vehar/SMPS-Noise-Filter/datasheets/Omron S8FS - Sample Photo.jpg

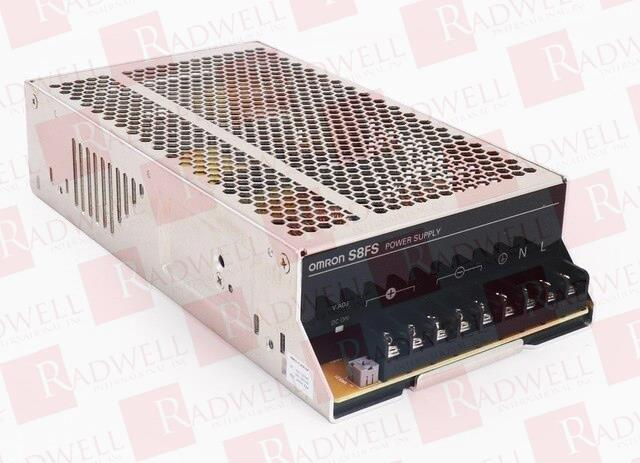
datasheets/Omron S8FS - Sample Photo.jpg
