vehar/SMPS-Noise-Filter/datasheets/Omron-S8FS-C05012-30132897-01.jpg

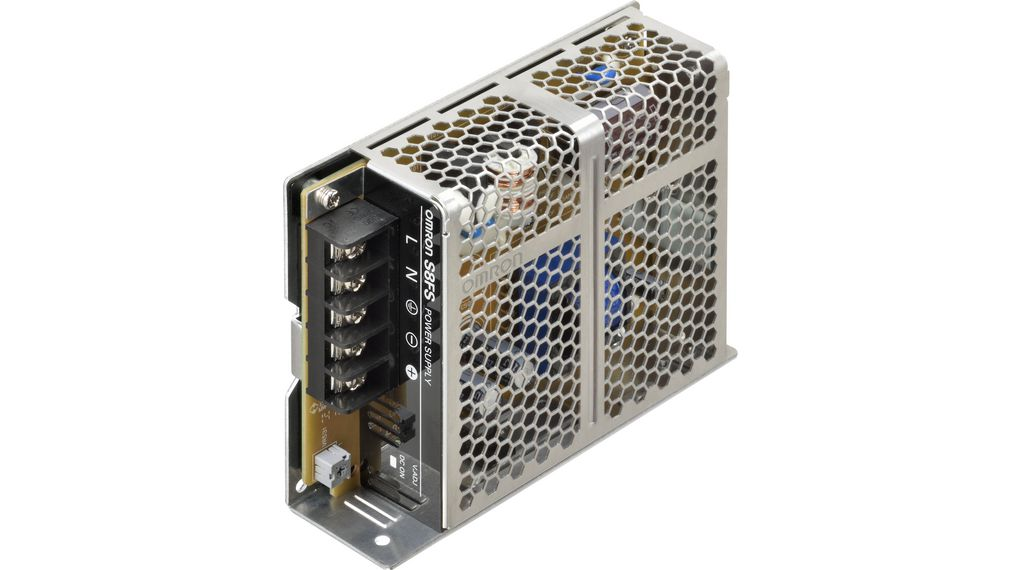
datasheets/Omron-S8FS-C05012-30132897-01.jpg
