vehar/SMPS-Noise-Filter/images/[Commercial CMC] Wurth-S14100038-Mouse-20A-Only.jpg

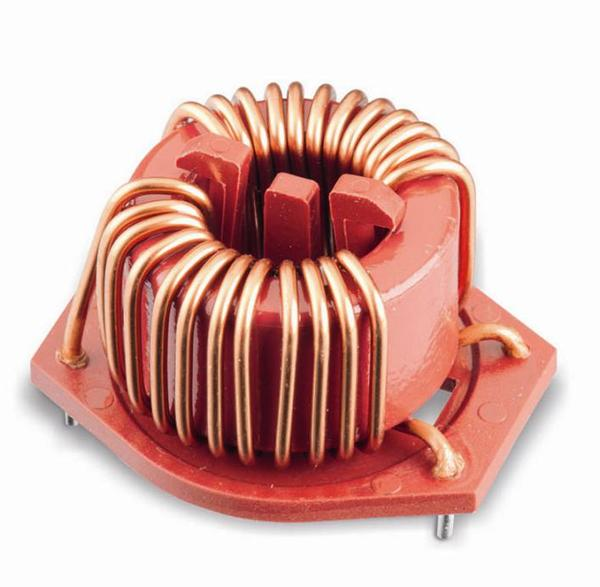
images/[Commercial CMC] Wurth-S14100038-Mouse-20A-Only.jpg
