vehar/SMPS-Noise-Filter/images/[eBay] Power supply filter board 4A EMI filter.jpg

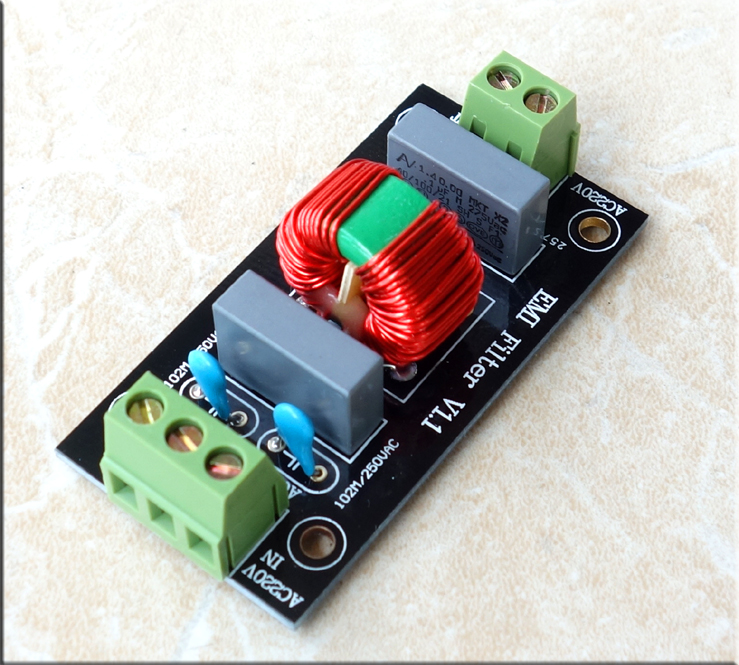
images/[eBay] Power supply filter board 4A EMI filter.jpg
