vehar/SMPS-Noise-Filter/images/B8272xE6_series_DSL.webp

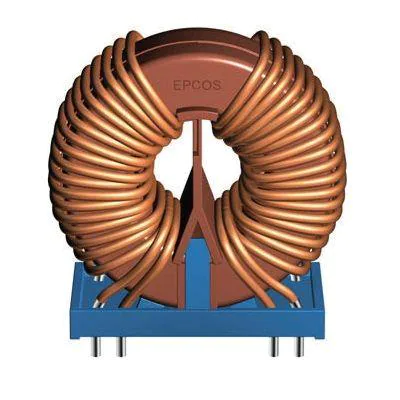
images/B8272xE6_series_DSL.webp
