vehar/SMPS-Noise-Filter/images/cmc_wide.png

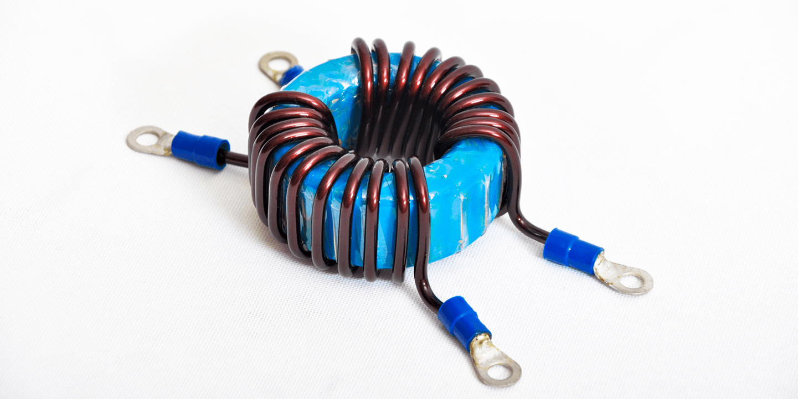
images/cmc_wide.png
