vehar/SMPS-Noise-Filter/images/EPCOS - TDK B8272xV2xUx Ring Core Double Chokes.webp

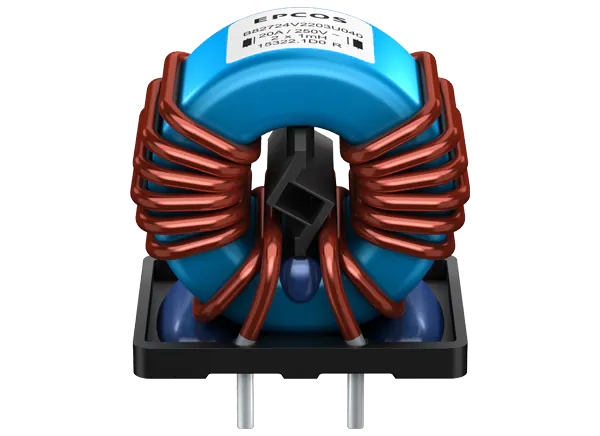
images/EPCOS - TDK B8272xV2xUx Ring Core Double Chokes.webp
