vehar/SMPS-Noise-Filter/images/Megas3300 - 1.jpeg

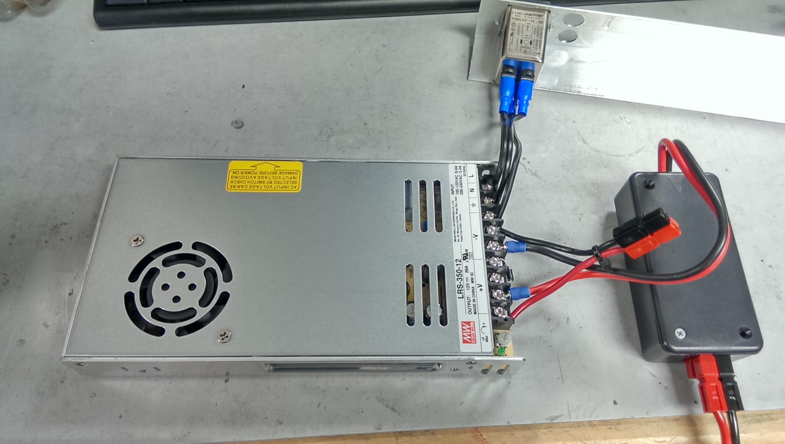
images/Megas3300 - 1.jpeg
