vehar/SMPS-Noise-Filter/images/Megas3300 - 2.jpeg

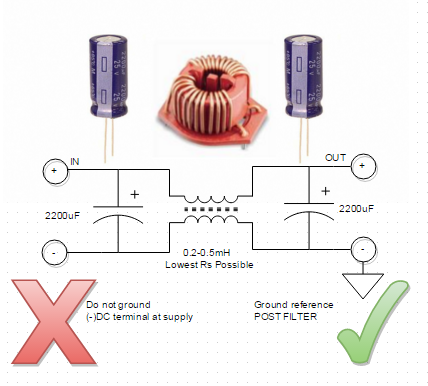
images/Megas3300 - 2.jpeg
