vehar/SMPS-Noise-Filter/images/Screenshot_2021-09-07_18-41-37.png

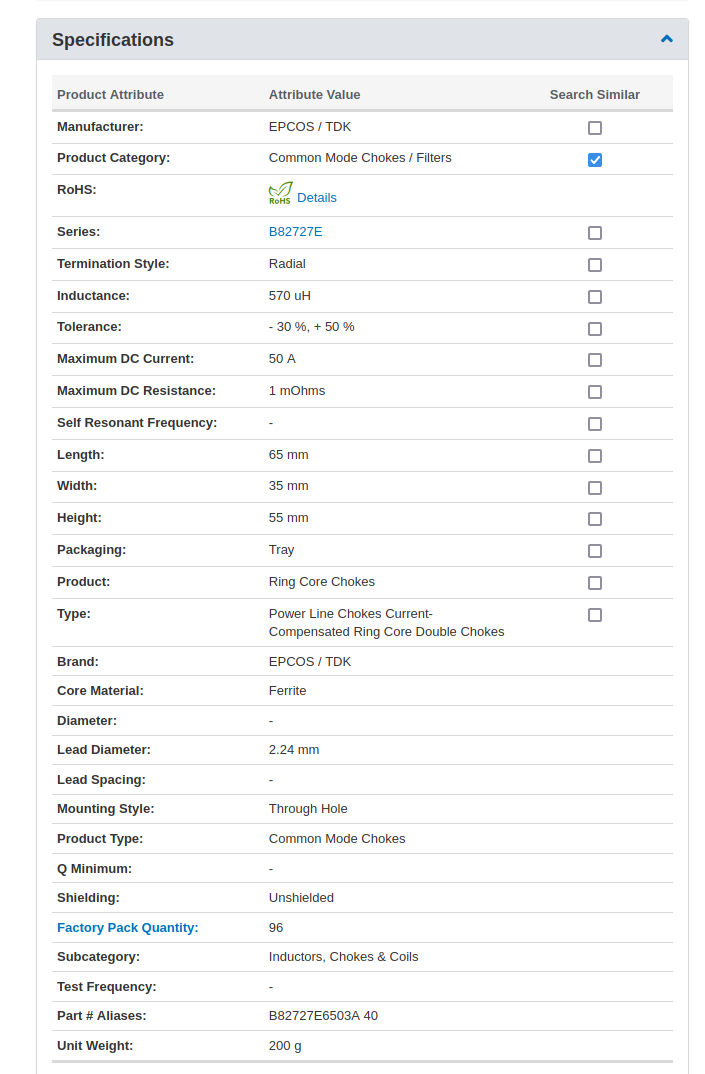
images/Screenshot_2021-09-07_18-41-37.png
