vehar/SMPS-Noise-Filter/images/Screenshot_2021-09-08_13-42-32.png

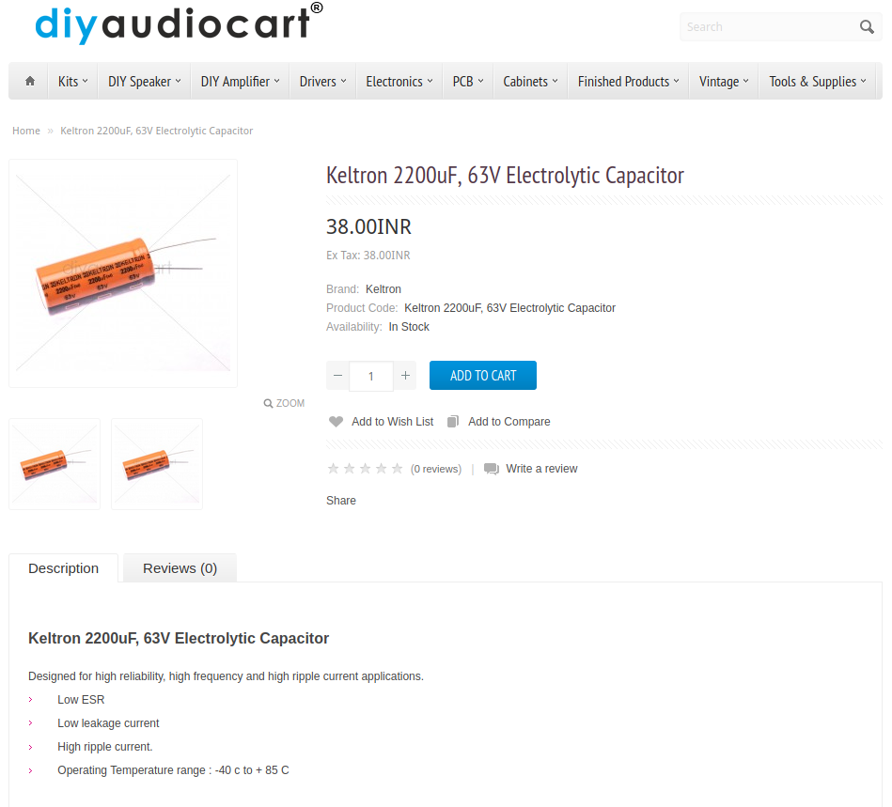
images/Screenshot_2021-09-08_13-42-32.png
