vehar/SMPS-Noise-Filter/images/Wurth 2.2MH 5A CMC.webp

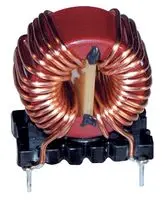
images/Wurth 2.2MH 5A CMC.webp
