vehar/SMPS-Noise-Filter/references/elcom-emi-filter.jpg

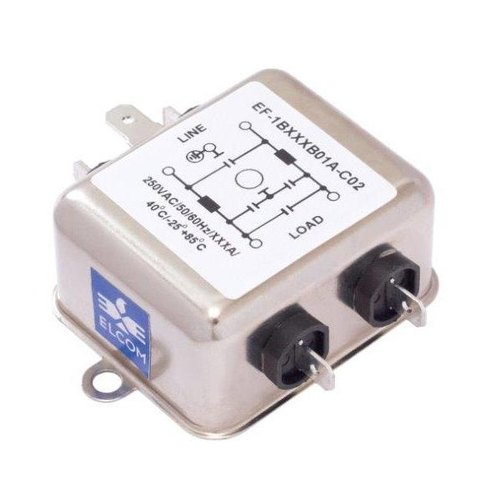
references/elcom-emi-filter.jpg
