vehar/SMPS-Noise-Filter/references/rfi-emi-ac-single-phase-panel-type-mounting-filter-500x500.jpg

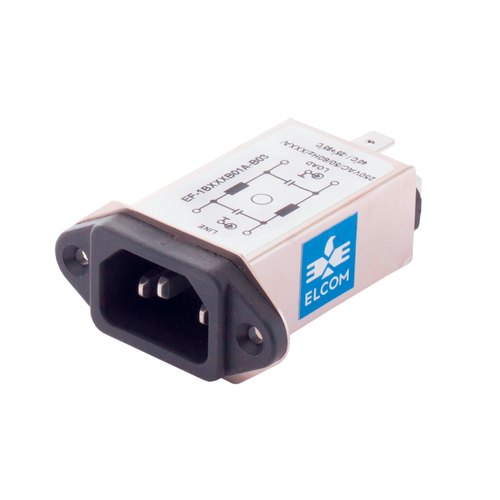
references/rfi-emi-ac-single-phase-panel-type-mounting-filter-500x500.jpg
