vehar/SMPS-Noise-Filter/simulations/Buck Ripple + Noise - Screenshot_2021-02-02_11-28-45.png

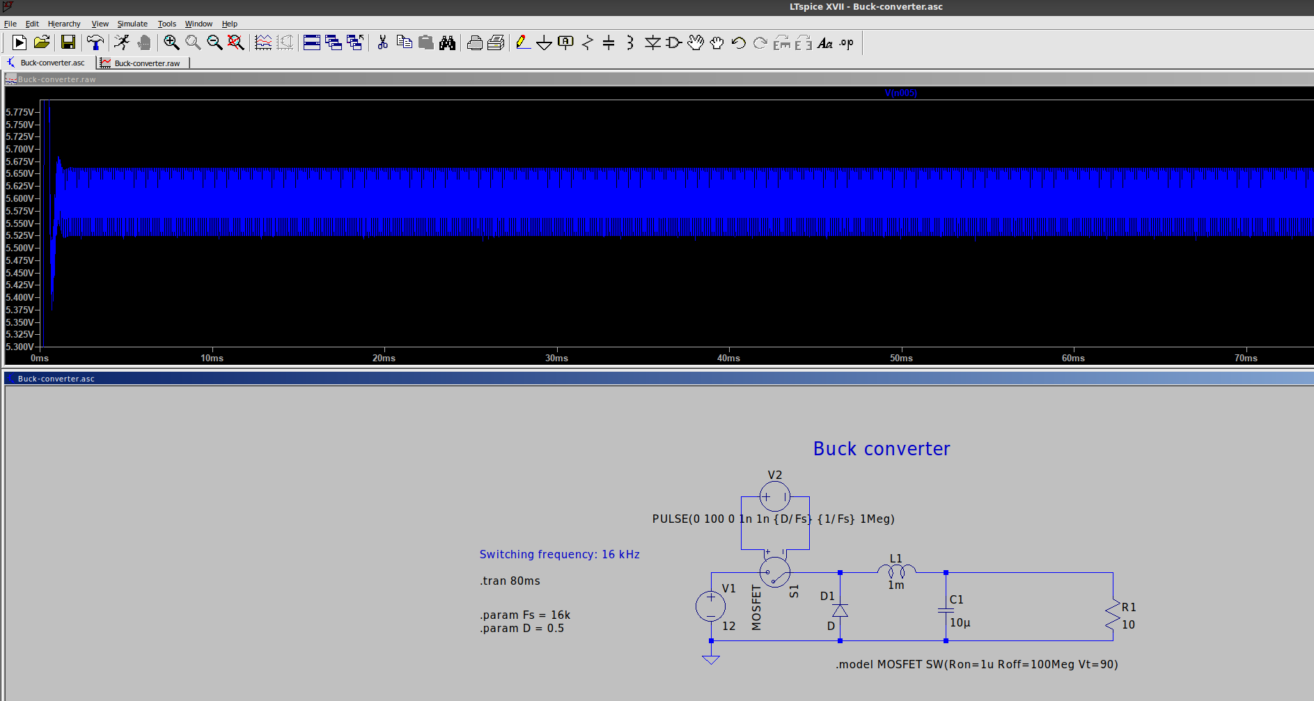
simulations/Buck Ripple + Noise - Screenshot_2021-02-02_11-28-45.png
