vehar/SMPS-Noise-Filter/simulations/Screenshot_2021-04-11_00-31-12.png

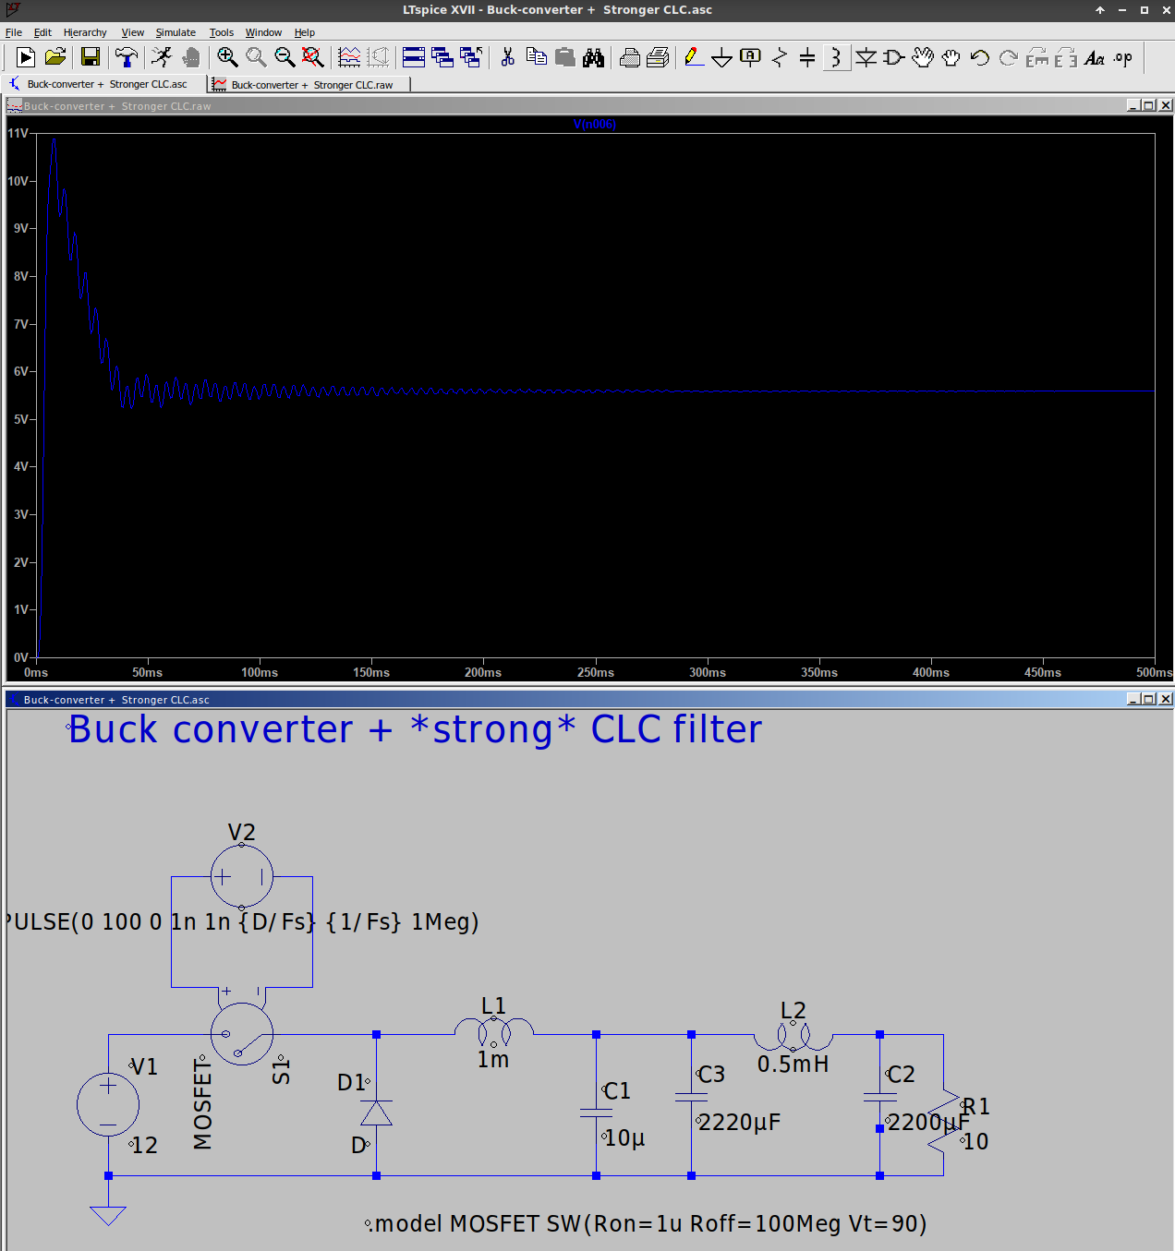
simulations/Screenshot_2021-04-11_00-31-12.png
