vehar/SMPS-Noise-Filter/simulations/Screenshot_2021-04-11_00-37-34.png

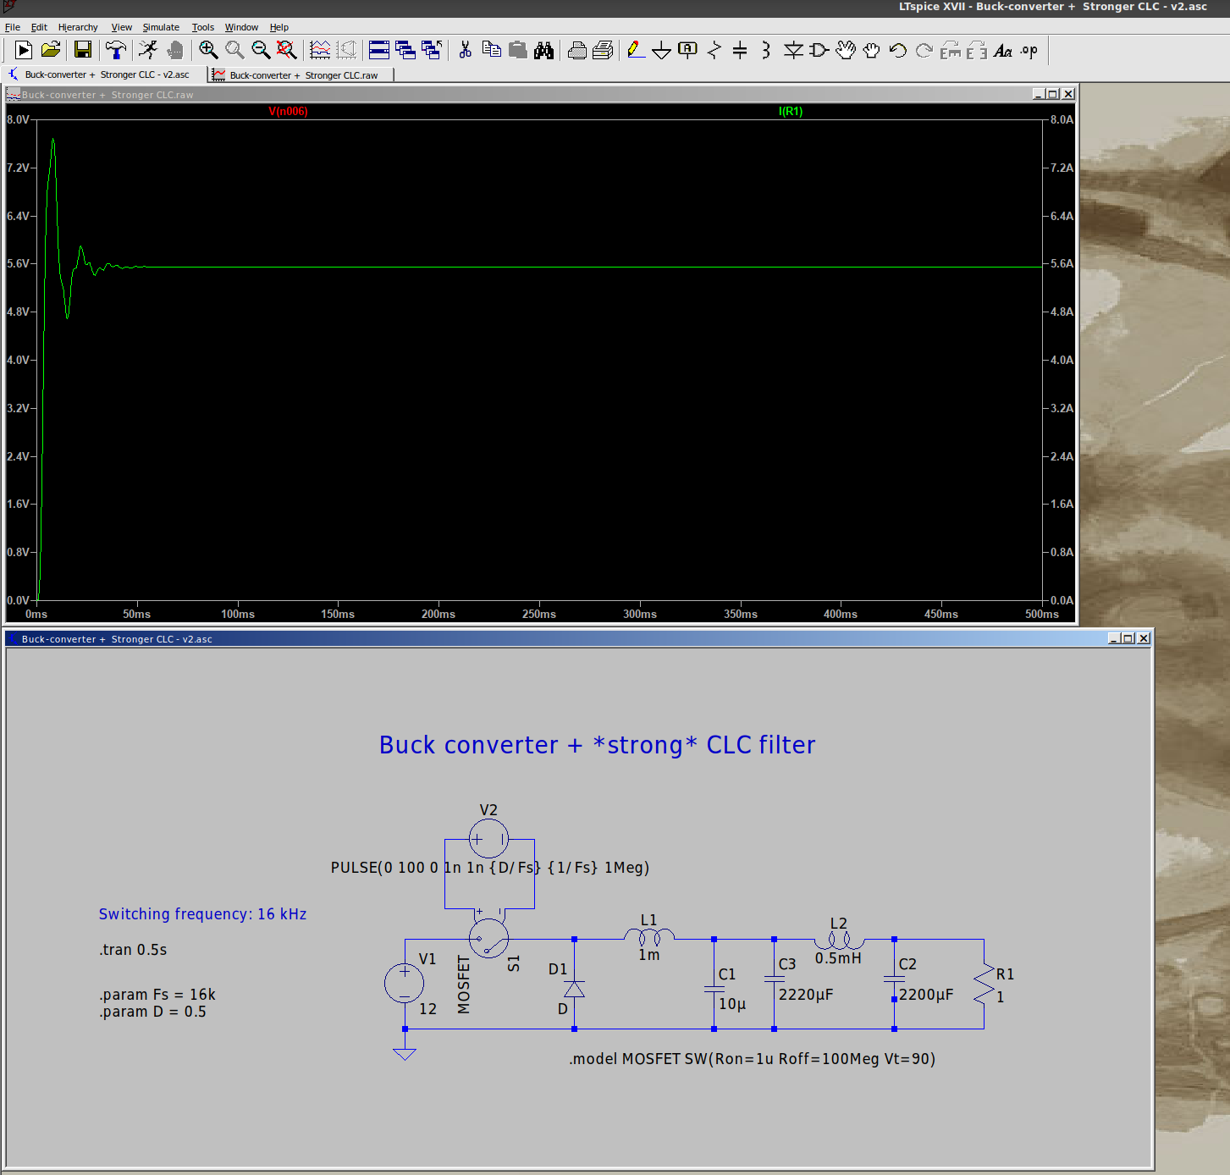
simulations/Screenshot_2021-04-11_00-37-34.png
