vehar/SMPS-Noise-Filter/simulations/Screenshot_2021-04-12_21-55-04.png

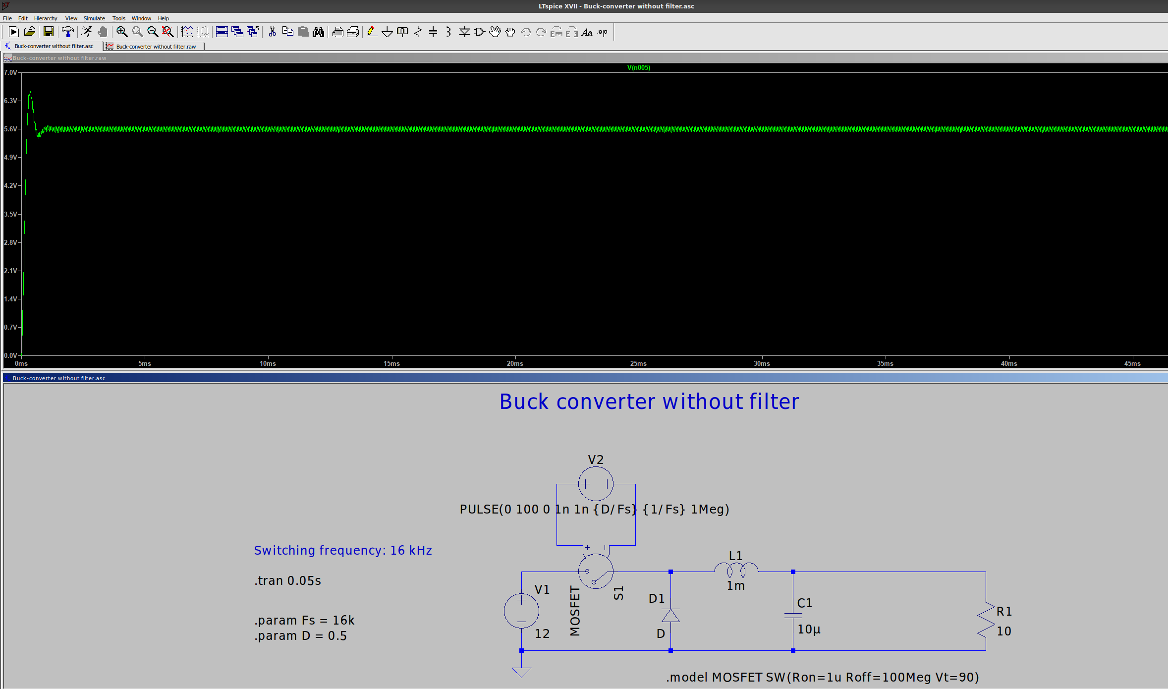
simulations/Screenshot_2021-04-12_21-55-04.png
