vehar/SMPS-Noise-Filter/simulations/Screenshot_2021-07-18_20-31-12.png

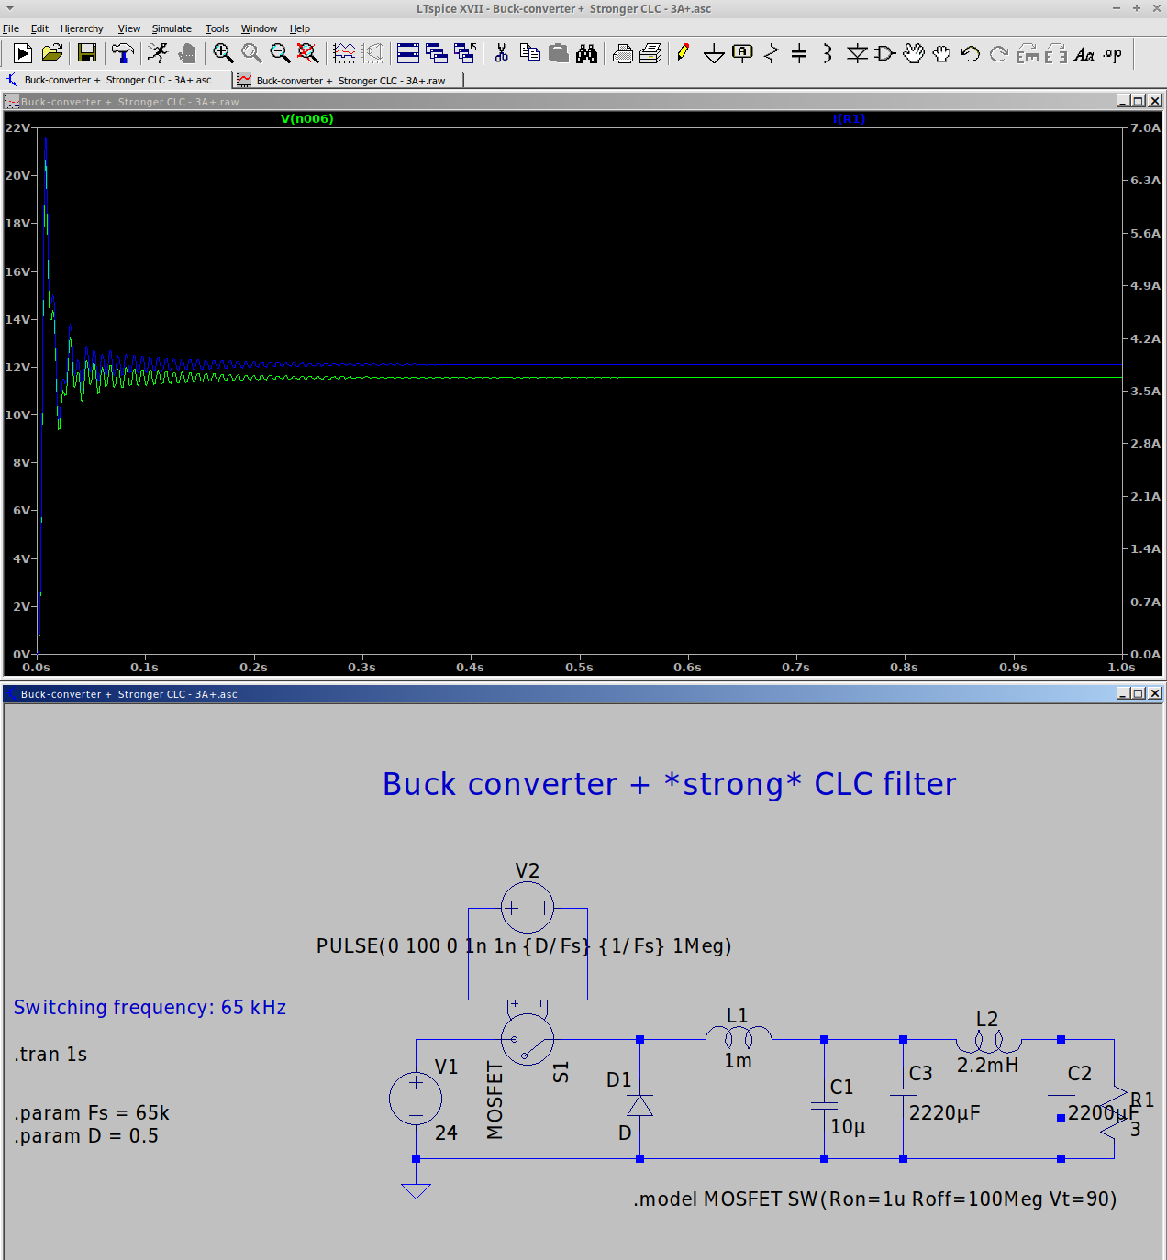
simulations/Screenshot_2021-07-18_20-31-12.png
