vehar/SMPS-Noise-Filter/simulations/Screenshot_2021-07-18_20-33-49.png

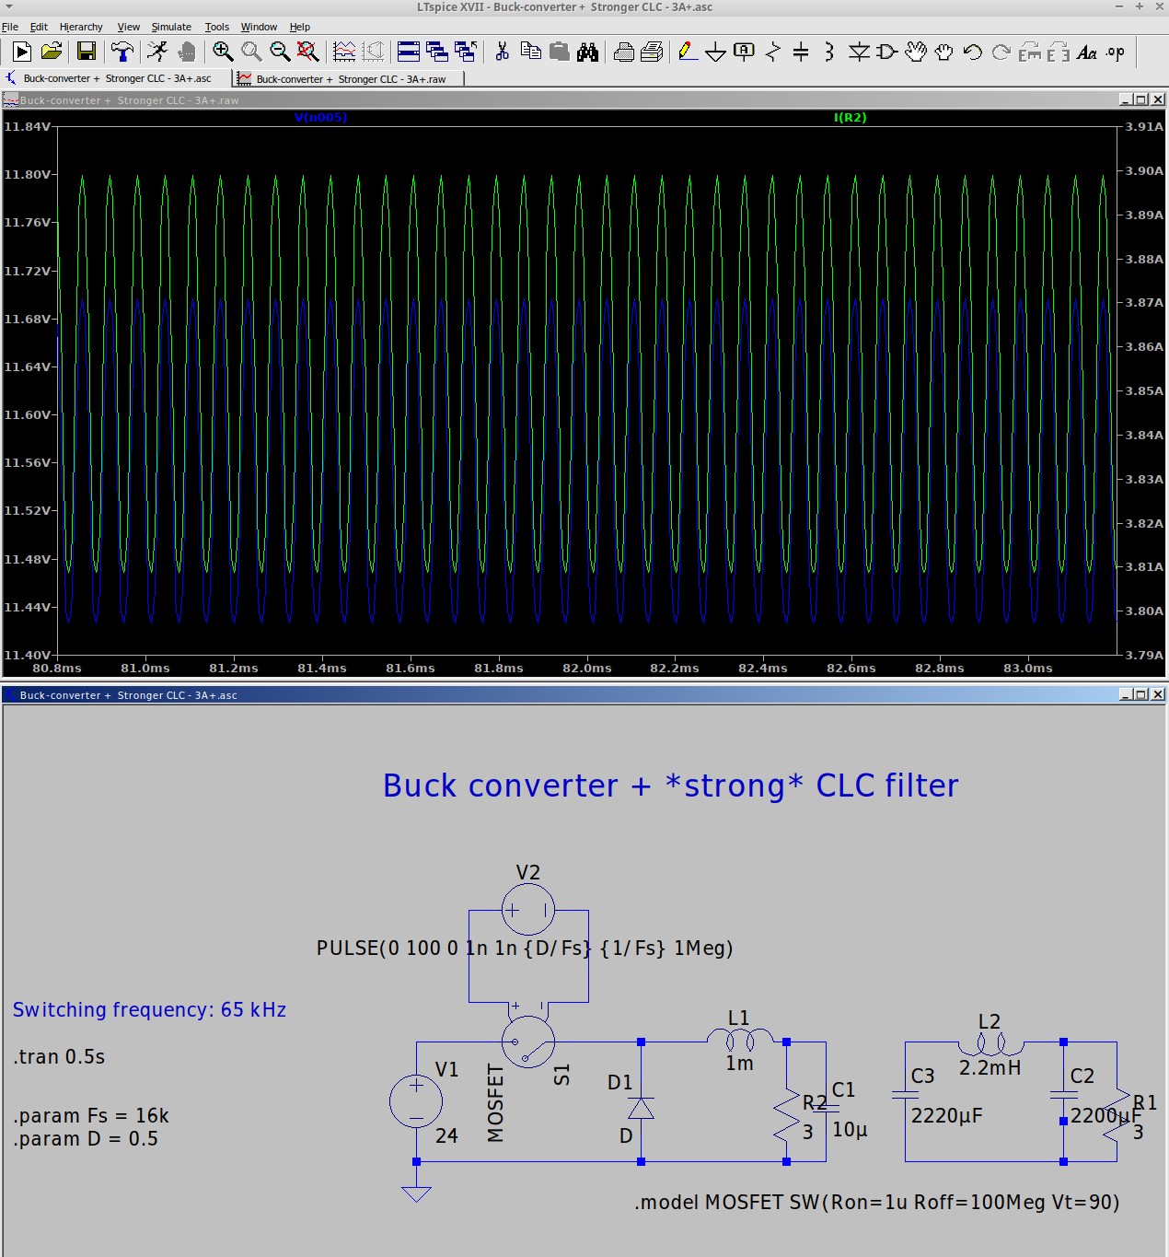
simulations/Screenshot_2021-07-18_20-33-49.png
