vehar/SMPS-Noise-Filter/simulations/Buck-converter +  Stronger CLC - 25A+.asc

C1: cap; 10µ
C2: cap; 2200µF
C3: cap; 2220µF
D1: diode
L1: ind; 1m
L2: ind; 0.5mH
R1: res; 10
S1: sw; MOSFET
V1: voltage; 12
V2: voltage; PULSE(0 100 0 1n 1n {D/Fs} {1/Fs} 1Meg)
Named nets: 0
.tran 0.5s
.model MOSFET SW(Ron=1u Roff=100Meg Vt=90)
Switching frequency: 16 kHz
.param Fs = 16k
.param D = 0.5
Buck converter + *strong* CLC filter
