vehar/SMPS-Noise-Filter/simulations/Buck-converter +  Stronger CLC - 3A+.asc

C1: cap; 10µ
C2: cap; 2200µF
C3: cap; 2220µF
D1: diode
L1: ind; 1m
L2: ind; 2.2mH
R1: res; 3
S1: sw; MOSFET
V1: voltage; 24
V2: voltage; PULSE(0 100 0 1n 1n {D/Fs} {1/Fs} 1Meg)
Named nets: 0
.tran 1s
.model MOSFET SW(Ron=1u Roff=100Meg Vt=90)
Switching frequency: 65 kHz
.param Fs = 16k
.param D = 0.5
Buck converter + *strong* CLC filter
