vehar/SMPS-Noise-Filter/SMPS-Output-Filter.sch

## KiCad design SMPS-Output-Filter.sch (2022-02-11)

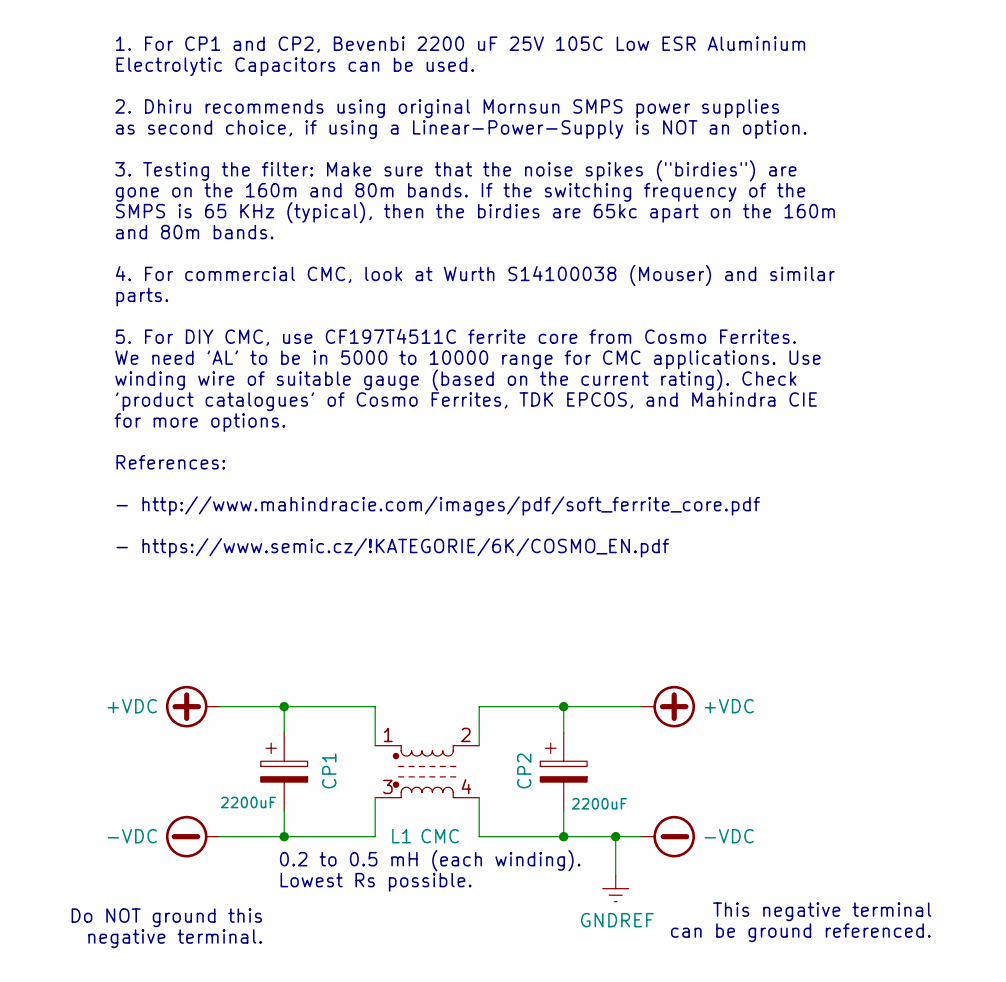
[picture p27: schematic SMPS-Output-Filter.sch]

Parts:
CP1, CP2: 2200uF
L1: CMC

Connections:
+VDC: CP1.1, CP2.1, L1.1, L1.2
-VDC: CP1.2, CP2.2, L1.3, L1.4

Notes on the sheet:
Do NOT ground this negative terminal.
This negative terminal can be ground referenced.
1. For CP1 and CP2, Bevenbi 2200 uF 25V 105C Low ESR Aluminium Electrolytic Capacitors can be used. 2. Dhiru recommends using original Mornsun SMPS power supplies as second choice, if using a Linear-Power-Supply is NOT an option. 3. Testing the filter: Make sure that the noise spikes ("birdies") ar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
0.2 to 0.5 mH (each winding). Lowest Rs possible.
