vehar/SMPS-Noise-Filter/images/[eBay] EMI RFI Common Mode Filter - assembled .jpeg

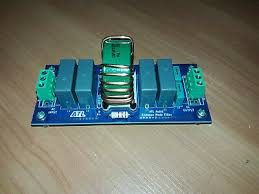
images/[eBay] EMI RFI Common Mode Filter - assembled .jpeg
