vehar/SMPS-Noise-Filter/references/From - Maxim Tutorial 716.gif

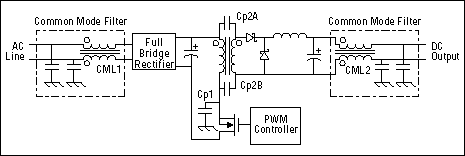
references/From - Maxim Tutorial 716.gif
